rmemory/CurrentSink/README.md

Building a current sink for battery testing
