rmemory/CurrentSink/SPICE/csos.asc

D1: diode; 1N914
M1: nmos; AP9465GEM
R1: res; .1R
R2: res; 1000
R3: res; 9k
R4: res; 1k
U1: UniversalOpamp2
U2: UniversalOpamp2
V1: voltage; PULSE(0 26 0 .2 .2 .3 1 1)
V2: voltage; .1
V3: voltage; 2.7
V4: voltage; 1
Named nets: 0, V, Vref
.tran 0 2 0
