rmemory/CurrentSink/CurrentSinkOrSwim.kicad_pcb

## KiCad design CurrentSinkOrSwim.kicad_pcb (2016-10-23)

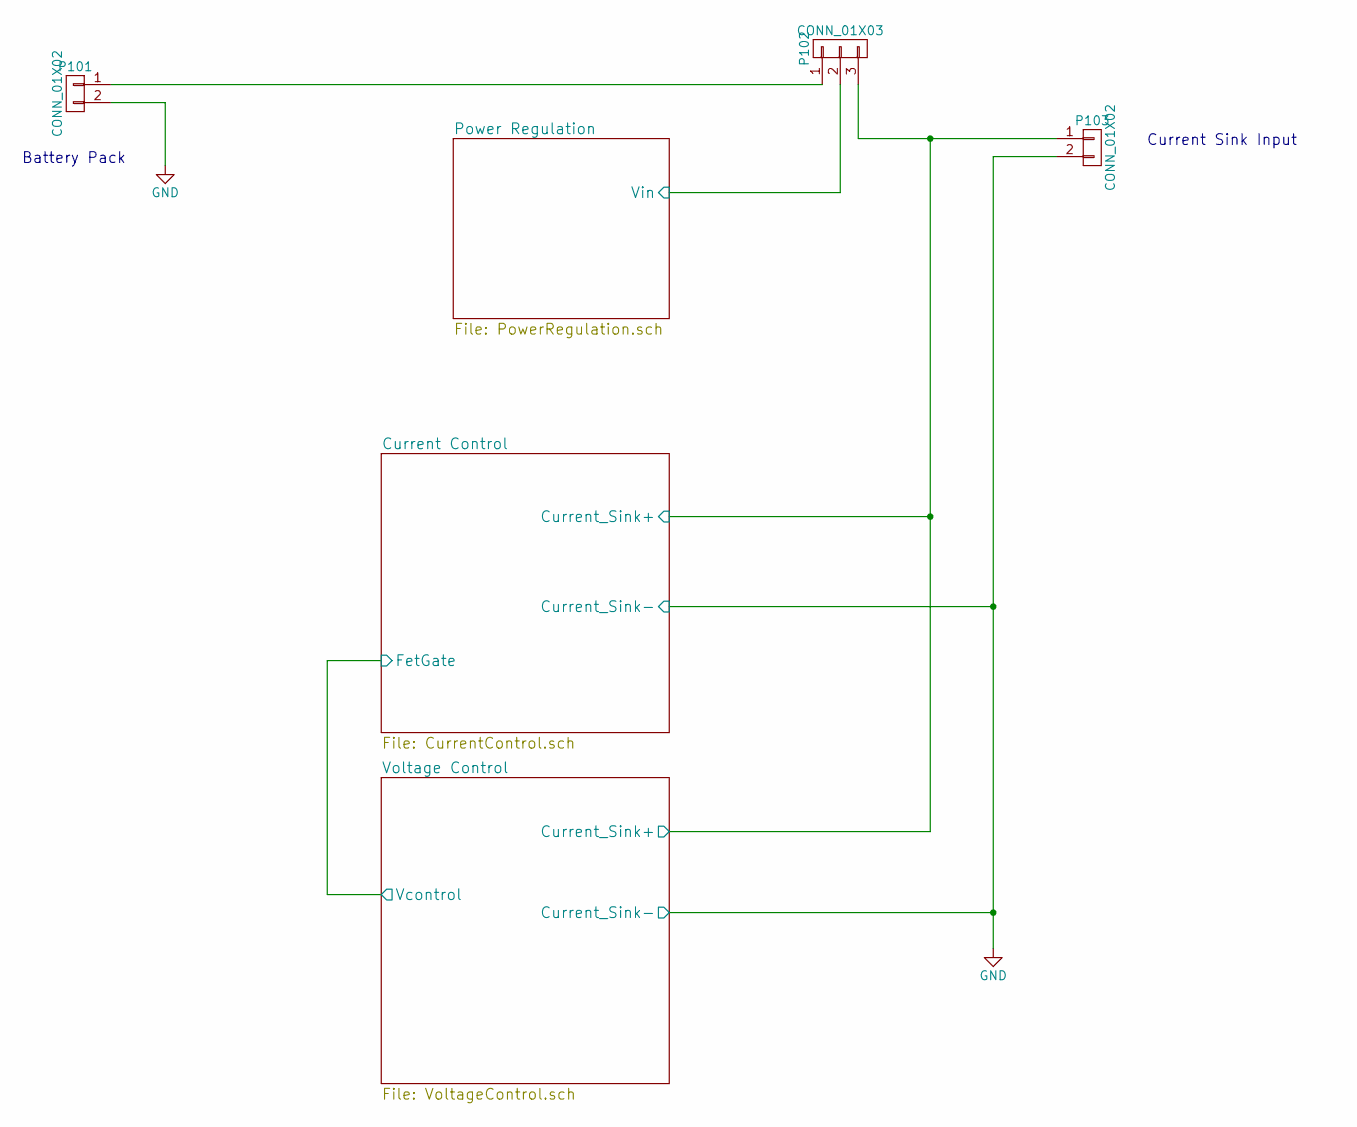
[picture p1: schematic CurrentSinkOrSwim.sch]

Parts:
P101, P103: CONN_01X02; Terminal_Block_200_mil; MPN OSTTC022162
P102: CONN_01X03; Pin_Header_Straight_1x03

Connections:
/Current Control/Current_Sink+: P102.3, P103.1; also elsewhere on the board
/Power Regulation/Vin: P102.2; also elsewhere on the board
GND: P101.2, P103.2; also elsewhere on the board
unnamed: P101.1, P102.1

Notes on the sheet:
Battery Pack
Current Sink Input

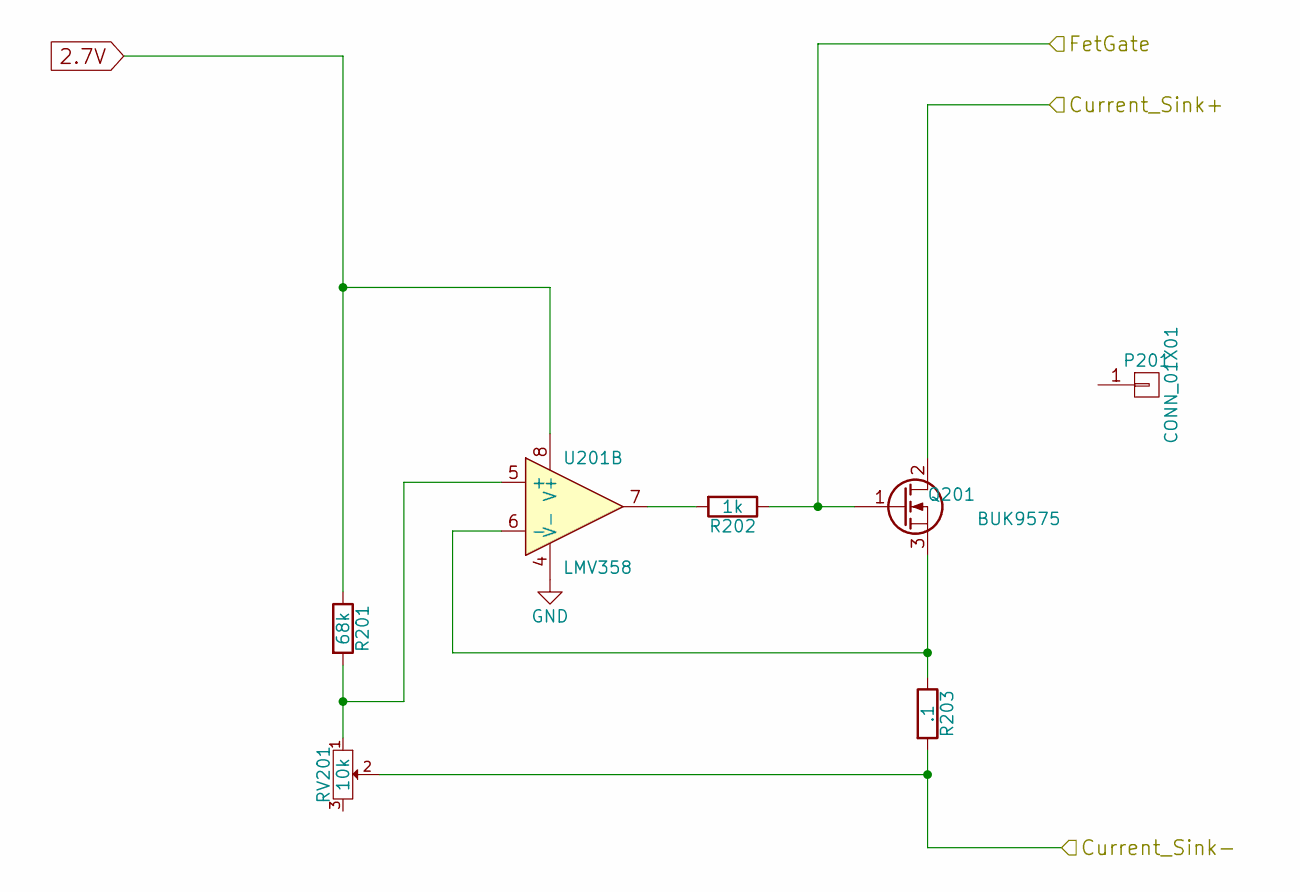
[picture p2: schematic CurrentControl.sch]

Parts:
P201: CONN_01X01; FA-T220-38E-ND; MPN FA-T220-38E-ND
Q201: BUK9575; TO-220_Neutral123_Vertical; MPN BUK9575-100A,127
R201: 68k; R_0805
R202: 1k; R_0805
R203: .1; Resistor_Horizontal_RM15mm; MPN AC01000001007JA100
RV201: 10k; P090L-02F25BR10K; MPN P090L-02F25BR10K
U201: LMV358; SOIC-8-N; MPN LMV358IDT

Connections:
2.7V: R201.1, U201.8 (V+); also elsewhere on the board
/Current Control/Current_Sink+: Q201.2 (D); also elsewhere on the board
/Current Control/FetGate: Q201.1 (G), R202.1; also elsewhere on the board
GND: R203.2, RV201.2, U201.4 (V-); also elsewhere on the board
unnamed: Q201.3 (S), R203.1, U201.6 (-)
unnamed: R201.2, RV201.1, U201.5 (+)
unnamed: R202.2, U201.7

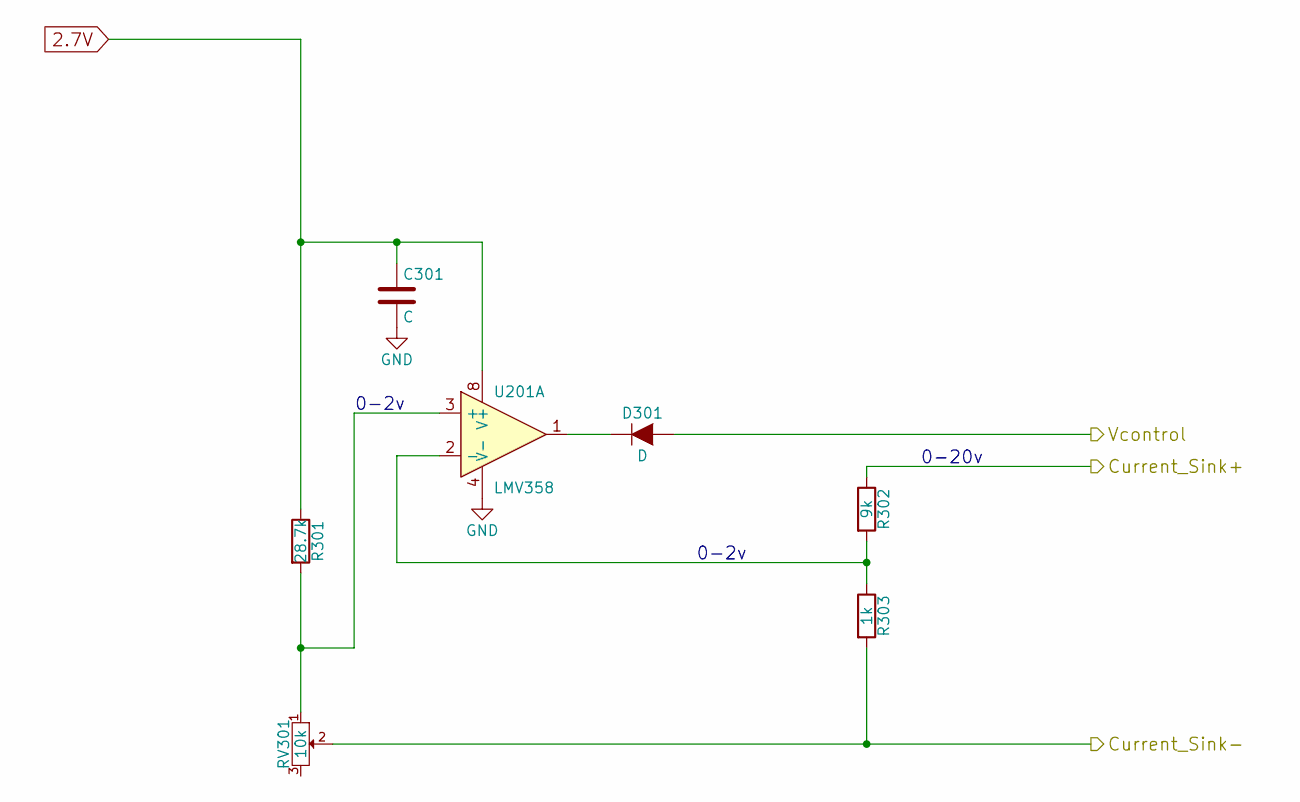
[picture p3: schematic VoltageControl.sch]

Parts:
C301: C; C_0805
D301: D; SMB-SMC_Universal_Handsoldering; MPN CD214B-R3600
R301: 28.7k; R_0805
R302: 9k; R_0805
R303: 1k; R_0805
RV301: 10k; P090L-02F25BR10K
U201: LMV358; SOIC-8-N; MPN LMV358IDT

Connections:
2.7V: C301.1, R301.1, U201.8 (V+); also elsewhere on the board
/Current Control/Current_Sink+: R302.1; also elsewhere on the board
/Current Control/FetGate: D301.2 (A); also elsewhere on the board
GND: C301.2, R303.2, RV301.2, U201.4 (V-); also elsewhere on the board
unnamed: D301.1 (K), U201.1
unnamed: R301.2, RV301.1, U201.3 (+)
unnamed: R302.2, R303.1, U201.2 (-)

Notes on the sheet:
0-2v
0-20v

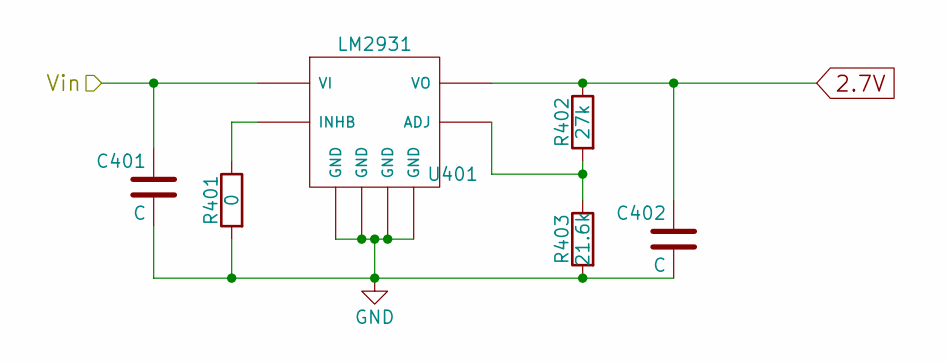
[picture p4: schematic PowerRegulation.sch]

Parts:
C401, C402: C; C_0805
R401: 0; R_0805
R402: 27k; R_0805
R403: 21.6k; R_0805
U401: LM2931; SOIC-8-N; MPN LM2931D-R

Connections:
2.7V: C402.1, R402.1, U401.1 (VO); also elsewhere on the board
/Power Regulation/Vin: C401.1, U401.8 (VI); also elsewhere on the board
GND: C401.2, C402.2, R401.2, R403.2, U401.2 (GND), U401.3 (GND), U401.6 (GND), U401.7 (GND); also elsewhere on the board
unnamed: R401.1, U401.5 (INHB)
unnamed: R402.2, R403.1, U401.4 (ADJ)

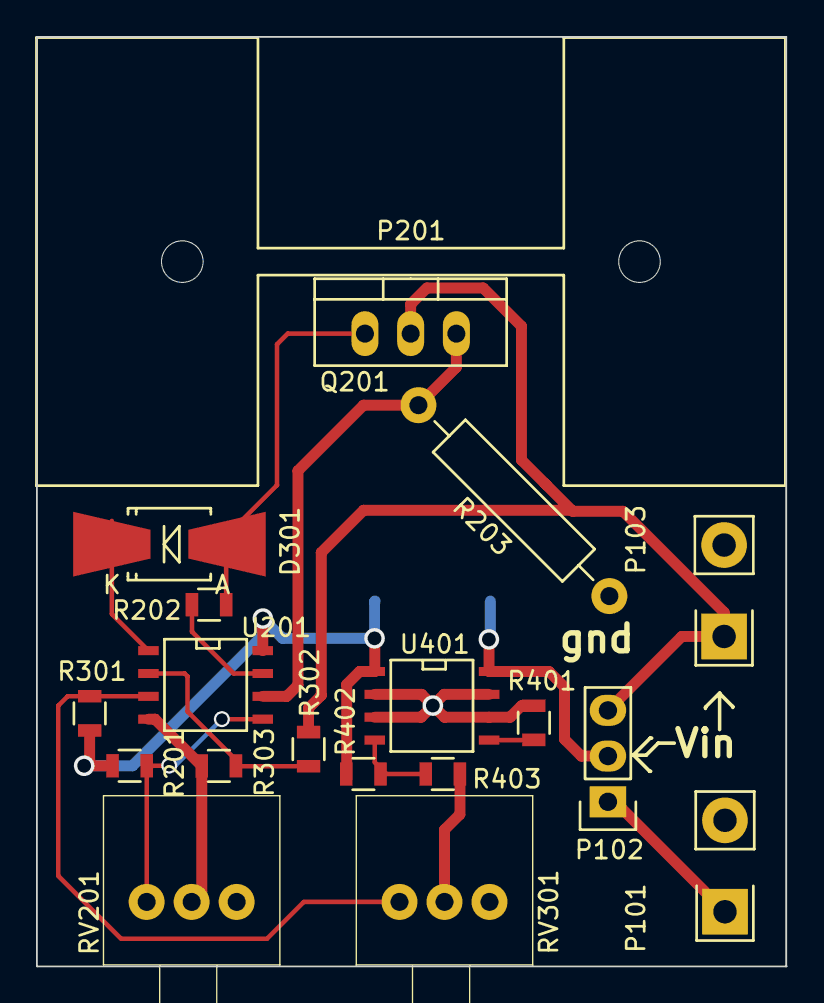
[picture p5: board CurrentSinkOrSwim.kicad_pcb from above]

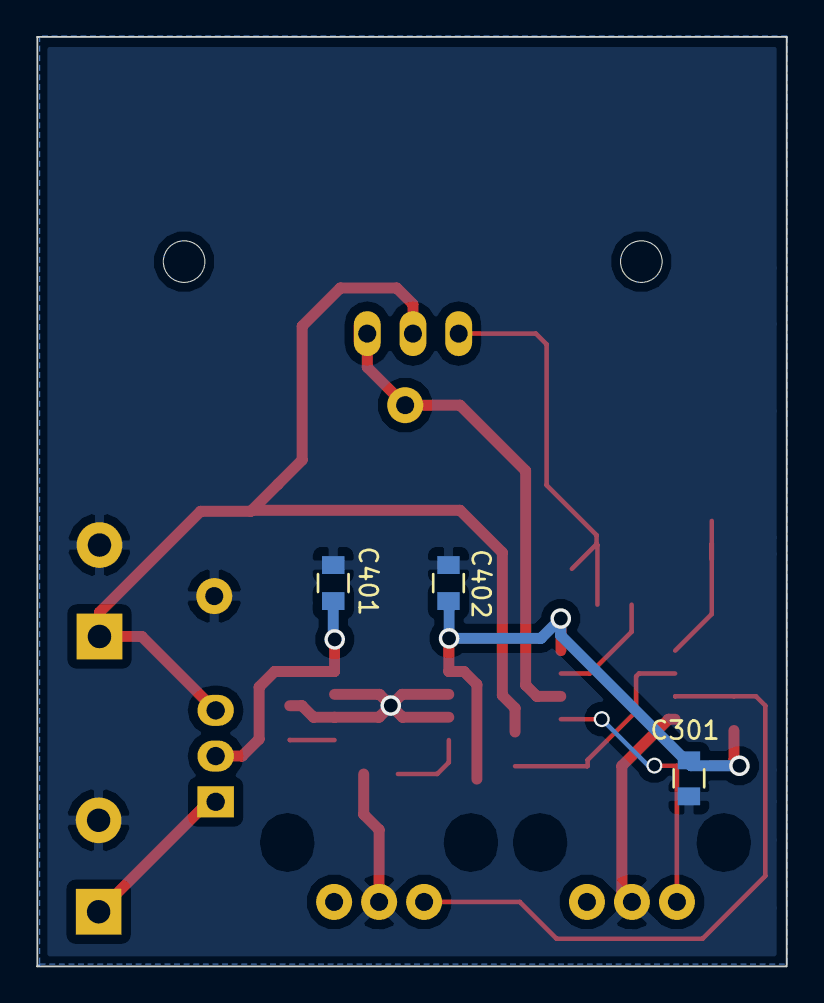
[picture p6: board CurrentSinkOrSwim.kicad_pcb from below]

Board: 2 copper layers, 41.7 x 51.6 mm, 22 parts (3 on the bottom side), 14 nets.
