rmemory/CurrentSink/(commit log)

2016-08-17 KiCad project and schematic creation
    [CurrentSinkOrSwim.kicad_pcb, CurrentSinkOrSwim.sch]
2016-08-27 Inital schmatic
    [CurrentSinkOrSwim.sch]
2016-08-31 Add spice simulation, and also a couple part numbers for resister and FET
    [CurrentSinkOrSwim.sch]
2016-09-07 minor mods to the schematic
    [_saved_CurrentSinkOrSwim.sch]
2016-09-11 Added variable regulator to circuit
    [CurrentSinkOrSwim.sch, _saved_CurrentSinkOrSwim.sch]
2016-09-14 updated spice simulation
    [CurrentSinkOrSwim.sch]
2016-09-14 Added a cutoff voltage divider as well as cutoff op amp
2016-09-16 Create hierarchical sheets
    [CurrentControl.sch, CurrentSinkOrSwim.sch, PowerRegulation.sch, VoltageControl.sch]
2016-09-16 Annotation completed
    [CurrentControl.sch, CurrentSinkOrSwim.sch, PowerRegulation.sch, VoltageControl.sch]
2016-09-24 Add initial layout
    [CurrentControl.sch, CurrentSinkOrSwim.kicad_pcb, CurrentSinkOrSwim.sch, PowerRegulation.sch, VoltageControl.sch]
2016-09-24 Add heat sink footprint
    [CurrentControl.sch, CurrentSinkOrSwim.kicad_pcb, PowerRegulation.sch, VoltageControl.sch]
2016-09-26 Remove extra erroneus LMV358
    [CurrentControl.sch, CurrentSinkOrSwim.kicad_pcb, VoltageControl.sch]
2016-09-26 Forgot to update the layout after removing the extra LMV358
    [CurrentSinkOrSwim.kicad_pcb]
2016-09-26 First pass of all components on the top layer of the board
    [CurrentSinkOrSwim.kicad_pcb]
2016-09-26 Minor update to layout
    [CurrentSinkOrSwim.kicad_pcb]
2016-09-27 Add potentiometers
    [CurrentControl.sch, CurrentSinkOrSwim.kicad_pcb, CurrentSinkOrSwim.sch, PowerRegulation.sch, VoltageControl.sch]
2016-09-27 Fixed divider resistors and found values
    [CurrentControl.sch, VoltageControl.sch]
2016-09-27 Update layout based on new pot and reisistor values
    [CurrentSinkOrSwim.kicad_pcb]
2016-09-28 Reorganization of layout, shrink board size, add ground plane
    [CurrentSinkOrSwim.kicad_pcb]
2016-10-03 Lets try layout one more time. Starting layout from scratch
    [CurrentControl.sch, CurrentSinkOrSwim.kicad_pcb, CurrentSinkOrSwim.sch]
2016-10-06 Intermediate layout version 2
    [CurrentSinkOrSwim.kicad_pcb, VoltageControl.sch]
2016-10-06 A very compressed layout
    [CurrentSinkOrSwim.kicad_pcb]
2016-10-06 Minor adjustment to the pot position
    [CurrentSinkOrSwim.kicad_pcb]
2016-10-06 Found a missed 2.7 connection
    [CurrentSinkOrSwim.kicad_pcb]
2016-10-15 Another complete layout ... hopefully better.
    [CurrentSinkOrSwim.kicad_pcb]
2016-10-16 Minor update to the 2.7v track trying to improve path to ground for middle via
    [CurrentSinkOrSwim.kicad_pcb]
2016-10-18 Version 3 of the layout
    [CurrentControl.sch, CurrentSinkOrSwim.kicad_pcb, PowerRegulation.sch, VoltageControl.sch]
2016-10-23 Add gerber files
    [CurrentSinkOrSwim-B.Cu.gbr, CurrentSinkOrSwim-B.Mask.gbr, CurrentSinkOrSwim-B.SilkS.gbr, CurrentSinkOrSwim-Edge.Cuts.gbr, CurrentSinkOrSwim-F.Cu.gbr, CurrentSinkOrSwim-F.Mask.gbr, CurrentSinkOrSwim-F.SilkS.gbr, CurrentSinkOrSwim.drl]
2016-10-23 Gerber file updates
    [CurrentSinkOrSwim-B.Cu.gbr, CurrentSinkOrSwim-B.Mask.gbr, CurrentSinkOrSwim-B.SilkS.gbr, CurrentSinkOrSwim-Edge.Cuts.gbr, CurrentSinkOrSwim-F.Cu.gbr, CurrentSinkOrSwim-F.Mask.gbr, CurrentSinkOrSwim-F.SilkS.gbr, CurrentSinkOrSwim.drl]
2016-10-23 Create zip file which has been submitted to oshpark
    [CurrentSinkOrSwim-B.Cu.gbl, CurrentSinkOrSwim-B.Mask.gbs, CurrentSinkOrSwim-B.SilkS.gbo, CurrentSinkOrSwim-Edge.Cuts.gko, CurrentSinkOrSwim-F.Cu.gtl, CurrentSinkOrSwim-F.Mask.gts, CurrentSinkOrSwim-F.SilkS.gto, CurrentSinkOrSwim.drl]
2016-10-24 Add preliminary BOM
    [CurrentControl.sch, CurrentSinkOrSwim.csv, PowerRegulation.sch, VoltageControl.sch]
2016-10-24 Final schematic and BOM and layout
    [CurrentControl.sch, CurrentSinkOrSwim.csv, CurrentSinkOrSwim.sch, PowerRegulation.sch, VoltageControl.sch]
